cdemetriadis/Thrustmaster-T300-Steering-Wheel-Emulator/hardware-list.md

# Hardware Parts & Tool List
Here's a detailed list of everything that went into building the steering wheel. 

## Parts

1. 1x Arduino Nano (or [compatible ATmega328P](https://grobotronics.com/nano-ch340-atmega328p-compatible-for-arduino-nano-v3.0.html))
0. 1x [16x2 Backlit LCD 3.3V screen](https://grobotronics.com/display-16x2-character-lcd-3.3v-blue.html)
0. 1x [I<sup>2</sup>C LCD Backpack](https://grobotronics.com/lcd-display-i2c-interface-module.html)
0. 3x Rotary Encoders (EC11)
0. 3x [I<sup>2</sup>C Encoder Mini v2.1](http://www.duppa.net/shop/i2c-encoder-mini/) boards
0. 1x [I<sup>2</sup>C Real-time clock](https://grobotronics.com/real-time-clock-module-with-eeprom.html) (DS1307 RTC)
0. 1x [2-5V Buzzer](https://grobotronics.com/buzzer-2-5v-30ma.html)
0. 2x [Mini 8-way Rotary Switches](https://www.hellasdigital.gr/electronics/components/mini-8-way-rotary-selector-switch-sp8t/)
0. 16x Push buttons (6x [NKK Style](https://www.cableworks.gr/ilektronika/arduino-and-microcontrollers/components-and-ic/buttons/ds-612-3-pin-6mm-dpdt-no-nc-red-reset-push-button/), 4x [12mm Momentary](https://grobotronics.com/push-button-momentary-12mm-red.html), 6x [7mm Momentary](https://grobotronics.com/momentary-button-panel-mount-black.html))
0. 2x [(ON)-OFF-(ON) Toggle switches](https://grobotronics.com/toggle-switch-on-off-on-sp3t-3a-250v-el.html)
0. 1x [5x7cm perfboard](https://grobotronics.com/50x70mm.html)
0. 1x [20cm USB-Mini extension](https://www.ebay.co.uk/itm/30cm-Angle-Mini-USB-5Pin-Male-to-Female-Extension-Adapter-Cable-Panel-Mount-Type/232825989994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)
0. 1x [6 Pin Mini-din adapter](https://www.3drap.it/product/mini-din-6-replacement-part-for-thrustmaster-wheels/)
0. 1x Steering Wheel enclosure ([F1 Kit by 3Drap.it](https://www.3drap.it/product/f1-steering-wheel-kit-by-3drap-thrustmaster-logitech-osw/))
0. Lots of 24-30AWG wires
0. Lots of Dupont type connectors
0. Pin Headers (Male/Female)
0. Various heatshrink tubes

## Tools

1. Soldering iron
0. Solder
0. Wire cutters
0. Needle nose pliers
0. Tweezers
0. Small philips screwdriver
0. Allen keys
0. Drill
0. USB to Mini USB (for programming the Arduino Nano)
