cdemetriadis/Thrustmaster-T300-Steering-Wheel-Emulator/button-mapping.md

# Button Mapping

Here are all the control bindings I've set in Assetto Corsa Competizione. These are mapped for the Playstation DualShock 4 controller.

| Wheel | PlayStation | Assetto Corsa Competizione |
| --- | --- | --- |
| Pit (Triangle) | **Triangle** | Pit Limiter |
| MFD (Square) | **Square** | Next Dash Page |
| HUD (Cross) | **Cross** | Cycle HUD MFD Up |
| Flash (Circle) | **Circle** | Flasher |
| L1 | **L1** | Shift Down |
| R1 | **R1** | Shift Up |
| L2 / Wipers | **L2** | Cycle Wiper |
| R2 / Lights | **R2** | Cycle Light Stages |
| L3 | **L3** | Decrease ABS |
| R3 | **R3** | Increase ABS |
| Toggle Up | **D-Pad Up** | Increase Brake Bias |
| Toggle Down | **D-Pad Down**  | Decrease Brake Bias |
| Toggle Right | **D-Pad Right** | Increase Traction Control  |
| Toggle Left | **D-Pad Left**  | Decrease Traction Control  |
