cdemetriadis/Thrustmaster-T300-Steering-Wheel-Emulator/(threads)

Thread 3 (2020-11-23):

CAB / Display Bug

cdemetriadis, 2020-11-23:
When the display is switched off I noticed that the CAB Mode button does not function properly. It does not properly select the mode.

I've tested the voltage and everything seems to be just fine. I need to further investigate as I currently do not know what is wrong.

Closed 2022-09-30.

Thread 10 (2021-04-06):

Button problem

Shane87F3Ng, 2021-04-06:

Closed 2021-04-06.

Thread 9 (2021-04-06):

Buttons are not constant

Shane87F3Ng, 2021-04-06:
First of all, thanks for the amazing work,

I realized, that Buttons are not constant pressed but flicker a lot. I do not use a rtc nor a display, just 3 encoders as you and some buttons. Therefore I modified the code, but it also happens with the original one. If i keep the button pushed, it is like i would very very very frequently push it. Any chance to look into it or does it happen because i do not use RTC, nor buzzer or reset? I use it on a TS-PC.

Best Regards!

cdemetriadis, 2021-04-07:
Try playing with the DEBOUNCE number. Currently it is on 90, but you could try raising it.

Shane87F3Ng, 2021-04-07:
That did IT! Thank you so much!

A general question, so you work on the advanced mode?

cdemetriadis, 2021-04-08:
> A general question, so you work on the advanced mode?

Not quite sure I understand.

Shane87F3Ng, 2021-04-08:
In the description, you said, that the advanced mode for PC is not yet working. So my question was, If you are still looking into that or if it was just a note :)

cdemetriadis, 2021-04-08:
Oh, that's just a note. I do not use a PC for gaming, so cannot test it.

I'm assuming the transition wouldn't be too hard though.

cdemetriadis, 2021-04-20:
Hey @Shane87F3Ng, I've added a new branch that works with the PC Advanced mode. Check it out here https://github.com/cdemetriadis/Thrustmaster-T300-Steering-Wheel-Emulator/tree/PC-Advanced-Mode

Shane87F3Ng, 2021-04-21:
Thanks for the Info! I will try it and see, if can use more buttons :)

cdemetriadis, 2021-04-22:
@Shane87F3Ng You can find the PC bindings here https://github.com/cdemetriadis/Thrustmaster-T300-Steering-Wheel-Emulator/blob/PC-Advanced-Mode/control-bindings.md

Closed 2021-04-19.

Thread 12 (2022-03-30):

Wire.h

Shane87F3Ng, 2022-03-30:
Hey mate,

Thanks again for your awesome work. I am building my second wheel at this point. I run into a problem. The original code does not include wire.h and wire.begin, but now, without including them, the arduino is stuck at setup while initialising the encoders..

Do you have any hint why this is happening? Which version of i2cminiencoderlib.h do you use?

Greetings

Closed 2022-03-30.

Thread 13 (2022-07-17):

T300 F1 wheel no display

les100, 2022-07-17:
Hi,
Thanks for your generosity in providing full details of your build. I am having a problem with not being able to display anything.
I have loaded the i2c demo from arduino ide and get the hello world. Loading your code i get nothing. I wondered if it had anything to do with the display on/off switch but cant see in your docs where this switch is connected. I even disconnected everything and just had the Display and nano connected and still nothing. Any help would be appreciated. Thanks,  Les

les100, 2022-07-18:
Thanks but i managed to sort it out.

eroyee, 2022-07-19:
@cdemetriadis I believe this issue was due to the OP not initialising the eeprom from t300_functions.ino?

Not sure whether you have any (software) build instructions but maybe it's worth including information around this and/or an if statement in the main code that will inform the operator if the eeprom is empty?

Apologies for not being specifically helpful and offering explicit code/text around this, but I'm not a user of your system (or indeed any such thing) and would hesitate to give further input without experience of what I was talking about... ;-)

les100, 2022-07-19:
@eroyee  Thanks for your suggestion,you were 100% correct,never had to do this before.A note to that effect would have been helpful.

cdemetriadis, 2022-07-19:
@eroyee @les100 Sorry for not being responsive on this issue. I've not touched this code in a while. I'd be more than happy if any of you contributed directly to the projected and made a pull request.

Thread 14 (2022-09-15):

Encoders displaying opposite Polarity

les100, 2022-09-15:
Hi,
When rotating any of the encoders anticlockwise is displaying + and clockwise a -.What have i got wrong.I am a novice with Arduino sorry.

Thanks
Les

cdemetriadis, 2022-09-30:
Hey there Les,

So, as I’ve already mentioned this in a reply somewhere on the internets, you could save this with a software change. I cannot test this change currently as I’ve not a working version of the wheel/arduino. BUT, it should be fairly straight forward.

In the `t300_functions.ino` file, you will find the trigger for each of the Encoders. Line 36 and onward:

```
void encoderBB_decrement(i2cEncoderMiniLib* obj) {
 buttonValue = 1100;
}
void encoderBB_increment(i2cEncoderMiniLib* obj) {
 buttonValue = 1000;
}
void encoderABS_decrement(i2cEncoderMiniLib* obj) {
 buttonValue = 3000;
}
void encoderABS_increment(i2cEncoderMiniLib* obj) {
 buttonValue = 3100;
}
void encoderTC_decrement(i2cEncoderMiniLib* obj) {
 buttonValue = 2000;
}
void encoderTC_increment(i2cEncoderMiniLib* obj) {
 buttonValue = 2100;
}
```

To swap the -/+ actions, you’d probably only need to change the buttonValue for each. As an example, in this case, your code should become:

```
void encoderBB_decrement(i2cEncoderMiniLib* obj) {
 buttonValue = 1000;
}
void encoderBB_increment(i2cEncoderMiniLib* obj) {
 buttonValue = 1100;
}
void encoderABS_decrement(i2cEncoderMiniLib* obj) {
 buttonValue = 3100;
}
void encoderABS_increment(i2cEncoderMiniLib* obj) {
 buttonValue = 3000;
}
void encoderTC_decrement(i2cEncoderMiniLib* obj) {
 buttonValue = 2100;
}
void encoderTC_increment(i2cEncoderMiniLib* obj) {
 buttonValue = 2000;
}
```

But again, please forgive me as I cannot double check and test the above.

Trust me when I say that all of the code you see was initially trial and error for me as well ;)

Best of luck buddy!

Closed 2022-09-30.

Thread 15 (2023-06-16):

Clean Thrustmaster F1 code

miniraziel, 2023-06-16:
Hi, i've seen you fantastic job about this project a few time ago, i've made myself too a few wheels using T300RS emulation and also a work in progress with T-GT emulation(thanks to Taras for his work), i would like to ask you if it is possible for you to publish the code to emulate the Thrustmaster F1 wheel(the one you used for this project), but in a clean version. I mean without screen controls and in the original buttons form(like the original F1 wheel: 18 buttons and 2 encoders). I've already try to contact Bremme on thingiverse for the original code but i didn't gen answer... and Taras told me that he don't have the time to work anymore on these projects.
I'm not a programmer and except for a few buttons reordering i'm not able to modify your sketch or the bremme's one.
Thank you very much
Best regards
Roberto

miniraziel, 2023-06-16:
Wrong position, not an issue but a request.
sorry

Closed 2023-06-16.

Thread 17 (2024-07-05):

Help

Eplesx, 2024-07-05:
Hello,
I don't know if you still provide support on this issue, but,
I did everything right, the lights of the Arduino work when I plug it in, but none of the buttons work. What could be the reason?

I use 14 butons and 2 rotary switches

Eplesx, 2024-07-05:
Thanks for the answer,
I'm trying to use it on a computer too.
I wanted to insert a button and try it, but the button is constantly flashing. When I remove the button, the left button on the d pad on the screen is constantly flashing.
Do you have an idea?

Eplesx, 2024-07-05:
I only have buttons and rotaries, could it be because of the lcdyou added?
