cdemetriadis/Thrustmaster-T300-Steering-Wheel-Emulator/assets/f1-wheel-labels.pdf

TC1

BB

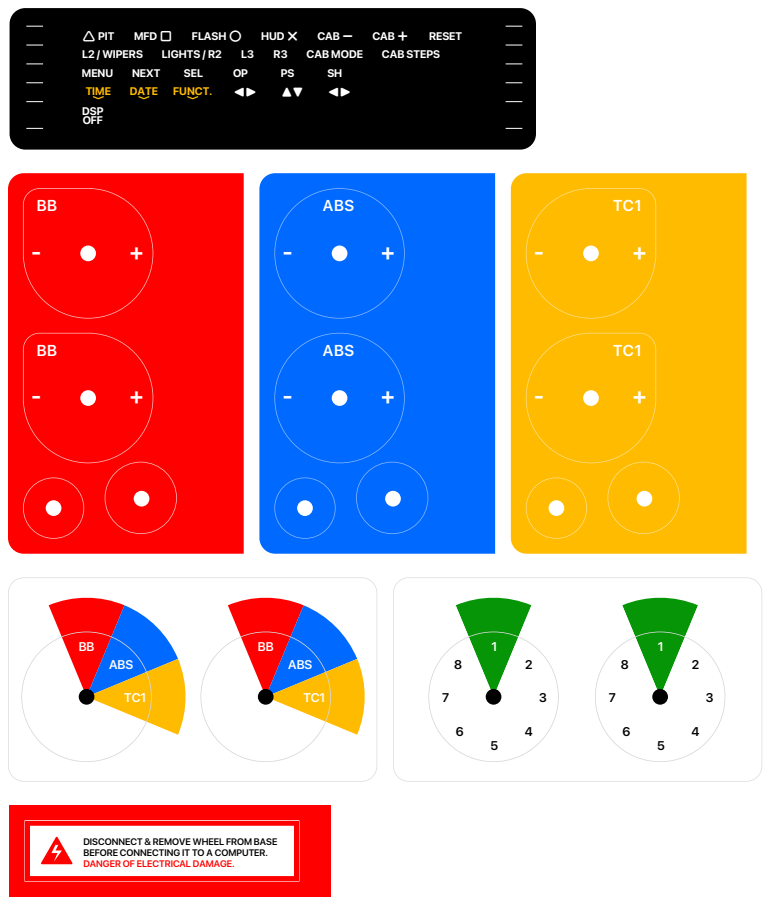
[picture p11: page 1]
ABS; MENU; DSP OFF; TIME; DATE; FUNCT.; NEXT; SEL; L2 / WIPERS; LIGHTS / R2; CAB MODE; CAB STEPS; % PIT; MFD '; FLASH &; HUD (; CAB ); CAB *; RESET; ABS - +

DISCONNECT & REMOVE WHEEL FROM BASE
BEFORE CONNECTING IT TO A COMPUTER.
DANGER OF ELECTRICAL DAMAGE.
