cdemetriadis/Thrustmaster-T300-Steering-Wheel-Emulator/t300_wheel_nano_lcd_switches/t300_wheel_nano_lcd_switches.ino

// Connect to Thrustmaster T300
//
// Arduino GND                        -> T300 Blue wire (2)
// Arduino pin 12                     -> T300 White wire (3) (data from wheel to base)
// Arduino pin 10 + pin 2 (SS)        -> T300 Orange wire pin (4) (yes, on Arduino it's wired to two pins. 10 - SS, 2 - INT0)
// Arduino pin 13 (SCK)               -> T300 Red wire (5)
// Arduino +5V                        -> T300 Black wire (6) (it gives 3.3V, but must be connected into +5V socket on arduino uno side)

#include      <EEPROM.h>                              // Load EEPROM library for storing settings
#include      <LiquidCrystal_I2C.h>                   // Load the Liquid Crystal Display library
#include      <i2cEncoderMiniLib.h>                   // Load I2C encoderBB Library
#include      <TimeLib.h>                             // Load Time Library
#include      <DS1307RTC.h>                           // Load the DS1307 RTC Library
 
#define       DEBUG_SETUP false                       // Debug Setup information
#define       DEBUG_KEYS false                        // Debug the button presses
#define       DEBUG_RESPONSE false                    // Debug the response time
#define       DEBUG_WHEEL false                       // Debug wheel output
#define       Rotary_Switch_T300 true                 // Select the values for the Rotary Switches. 'true:T300', 'false:USB'
#define       MESSAGE_DURATION 750                    // Duration of the messages on the screen
#define       DEBOUNCE 120                            // Set this to the lowest value that gives the best result

#define       MENU "~Ready"
#define       LOADING "Loading..."
#define       SELECT_OPTION " Select Option:"
#define       DISPLAY_MODE_ON "~Display Mode"
#define       DISPLAY_MODE_OFF " Display Mode"
#define       DISPLAY_KEYPRESS_ON "~Disp.Keypress"
#define       DISPLAY_KEYPRESS_OFF " Disp.Keypress"
#define       DISPLAY_STATUS_ON "~Display Off"
#define       DISPLAY_STATUS_OFF " Display Off"
#define       BUZZER_STATUS_ON "~Buzzer"
#define       BUZZER_STATUS_OFF " Buzzer"
#define       HOUR_CHIRP_ON "~Hour Chirp"
#define       HOUR_CHIRP_OFF " Hour Chirp"
#define       DISPLAY_RUNTIME_ON "~Display Runtime"
#define       KEYPRESS_ON "Keypress: On"
#define       KEYPRESS_OFF "Keypress: Off"
#define       MODE_PS "Mode: PS"
#define       MODE_WHEEL "Mode: Wheel"
#define       CHIRP_ON "Hour Chirp: On"
#define       CHIRP_OFF "Hour Chirp: Off"
#define       BUZZER_ON "Buzzer: On"
#define       BUZZER_OFF "Buzzer: Off"

// Setup EEPROM
bool          DISPLAY_MODE = EEPROM.read(0);          // Retrieve the display output mode. 'true:1' for Playstation, 'false:0' for Wheel
bool          DISPLAY_KEYS = EEPROM.read(1);          // Retrieve the display keypress option. 'true:1' on, 'false:0' off
bool          BUZZER_STATUS = EEPROM.read(2);         // Retrieve the buzzer status. 'true:1' on, 'false:0' off
bool          DISPLAY_STATUS = EEPROM.read(3);        // Retrieve the display status. 'true:1' on, 'false:0' off
bool          HOUR_CHIRP = EEPROM.read(4);            // Retrieve the hour chirp status. 'true:1' on, 'false:0' off


// Initialize Encoders
const int     IntPin = 3;
i2cEncoderMiniLib encoderBB(0x20);
i2cEncoderMiniLib encoderABS(0x21);
i2cEncoderMiniLib encoderTC(0x22);
int encoderIncCount = 0;
int encoderDecCount = 0;


// Setup LCD & vars
LiquidCrystal_I2C lcd(0x27, 16, 2);                   // Connects to 3.3V, GND, A4 (SDA), A5 (SCL)
int           curValue = -100;
String        prevLine_1;
String        prevLine_2;
void          printDisplay(String line_1="", int pos_1=0, String line_2="", int pos_2=0);
unsigned long displayTime;                            // Used for delaying the screen message


// Setup Real Time Clock
tmElements_t  tm;
String        getTime;
String        getDate;
bool          chirp_played = true;
String        tm_hour; 
String        tm_minute;
String        tm_month = "--";
String        tm_date = "--";


// Setup Buzzer 
#define       BUZZER_PIN 4
unsigned long buzzerTime;

// Menu Navigation Setup
int           menu = 0;
int           menuPage = 1;
int           maxPages = 1;


// CAB Setup - Combined action buttons
int           triggerCAB;
int           triggerSteps = 0;
int           triggerStepsIncrease = 0;
int           triggerStepsDecrease = 0;
int           CAB_ACTION;
int           CAB_STEPS;
unsigned long cabTrigger = millis();


// Button Matrix
int           foundColumn = 0;
int           buttonValue = 0;
byte          wheelState[8];
volatile      byte pos;


// Setup Button Matrix
int           rowPin[] = {5, 6, 7, 8, 9};           // Set pins for rows > OUTPUT
int           colPin[] = {A0, A1, A2, A3, 11};              // Set pins for columns, could also use Analog pins > INPUT_PULLUP
int           rowSize = sizeof(rowPin)/sizeof(rowPin[0]);
int           colSize = sizeof(colPin)/sizeof(colPin[0]);


// Button Matrix
//      Cols  |  0              1               2               4               5
// Rows Pins  |  14/A0          15/A1           16/A2           17/A3           11
// ---------------------------------------------------------------------------------------------
// 0    5     |  204 Triangle   225 Circle      247 Up          270 L2          147 L1
// 1    6     |  224 Square     246 Cross       269 Down        293 R2          164 R1
// 2    7     |  245 Menu       268 Options     292 left        317 CAB-        182 L3
// 3    8     |  267 Next       291 PS          316 Right       342 CAB+        201 R3
// 4    9     |  290 Select     315 Share       341             368             221


void setup() {
  
  resetVars();

  #if DEBUG_SETUP || DEBUG_KEYS || DEBUG_WHEEL || DEBUG_RESPONSE
     Serial.begin(115200);    // Arduino debug console
  #endif

  pinMode(MISO, OUTPUT); // Arduino is a slave device
  SPCR |= _BV(SPE);      // Enables the SPI when 1
  SPCR |= _BV(SPIE);     // Enables the SPI interrupt when 1

  pinMode(BUZZER_PIN, OUTPUT); // Set buzzer pin as OUTPUT
  
  // Interrupt for SS rising edge
  attachInterrupt (digitalPinToInterrupt(2), ss_rising, RISING); // Interrupt for Button Matrix
  
  // Setup Encoders
  pinMode(IntPin, INPUT);
  encoderBB.begin(i2cEncoderMiniLib::IPUP_ENABLE);
  encoderBB.onIncrement = encoderBB_increment;
  encoderBB.onDecrement = encoderBB_decrement;
  encoderABS.begin(i2cEncoderMiniLib::IPUP_ENABLE);
  encoderABS.onIncrement = encoderABS_increment;
  encoderABS.onDecrement = encoderABS_decrement;
  encoderABS.onButtonLongPush = toggleBacklight;
  encoderABS.writeDoublePushPeriod(50);
  encoderTC.begin(i2cEncoderMiniLib::IPUP_ENABLE);
  encoderTC.onIncrement = encoderTC_increment;
  encoderTC.onDecrement = encoderTC_decrement;

  encoderBB.autoconfigInterrupt();
  encoderABS.autoconfigInterrupt();
  encoderTC.autoconfigInterrupt();

  
  // Setup Display & Init message
  lcd.init();
  
  if (DISPLAY_STATUS) {
    lcd.backlight();
    lcd.clear();
  } else {
    lcd.noDisplay();
    lcd.noBacklight();
    lcd.clear();
  }

  printDisplay(LOADING);

  #if DEBUG_SETUP
    Serial.println("Thrustmaster Wheel Emulator v1.0");
    Serial.println();
    Serial.print("Setup ");
    Serial.print(rowSize);
    Serial.print("x");
    Serial.print(colSize);
    Serial.println(" Button Matrix");
  #endif

  // Row setup
  //
  // Set rows as OUTPUT
  for (int i=0; i<rowSize; i++) {
    pinMode(rowPin[i], OUTPUT);
    #if DEBUG_SETUP
      Serial.print("Pin: ");
      Serial.print(rowPin[i]);
      Serial.print(" is set as OUTPUT on row: ");
      Serial.println(i);
    #endif
  }

  // Column setup
  //
  // Set columns as INPUT_PULLUP
  for (int i=0; i<colSize; i++) {
    pinMode(colPin[i], INPUT_PULLUP);
    #if DEBUG_SETUP
      Serial.print("Pin: ");
      Serial.print(colPin[i]);
      Serial.print(" is set as INPUT_PULLUP on col: ");
      Serial.println(i);
    #endif
  }
  
  if (BUZZER_STATUS) {
    buzzerStartup();
  }

}


// Interrupt0 (external, pin 2) - prepare to start the transfer
void ss_rising () {
  SPDR = wheelState[0]; // load first byte into SPI data register
  pos = 1;
}


// SPI interrupt routine
ISR (SPI_STC_vect) {
  SPDR = wheelState[pos++]; // load the next byte to SPI output register and return.
}


String CABActionMap[] = {
  "BB",
  "ABS",
  "TC"
};

int CABActionGuide[3][2][2] = {
  { // BB
    {2, B10111111},   // D-Pad Down - wheelState[2] = wheelState[2] & B10111111;
    {2, B11110111}    // D-Pad Up - wheelState[2] = wheelState[2] & B11110111;
  },
  { // ABS
    {1, B11111101},  // L3 - wheelState[1] = wheelState[1] & B11111101;
    {1, B11111110}   // R3 - wheelState[1] = wheelState[1] & B11111110;
  },
  { // TC
    {2, B11101111},   // D-Pad Left - wheelState[2] = wheelState[2] & B11101111;
    {2, B11011111}    // D-Pad Right - wheelState[2] = wheelState[2] & B11011111;
  }
};

void loop() {
  
  #if DEBUG_RESPONSE
    unsigned long startLoop = micros();
  #endif
  
  if (digitalRead(IntPin) == LOW) {
    encoderBB.updateStatus();
    encoderABS.updateStatus();
    encoderTC.updateStatus();
  }

  //
  // Initiate Button Matrix
  // This functions returns a buttonValue for each button
  scanButtonMatrix();

  //
  // Set the action based on the buttonValue
  switch (buttonValue) {

    case 204: // Triangle
      wheelState[0] = wheelState[0] & B11111101;
      buzzer();
      if (DISPLAY_KEYS) {
        (DISPLAY_MODE) ? printDisplay("Triangle", 4) : printDisplay("Pit Limiter", 2);
        menu = 0;
      }
      #if DEBUG_KEYS
        Serial.print("Triangle ("); Serial.print(buttonValue); Serial.println(") ");
      #endif
      break;

    case 224: // Square
      wheelState[0] = wheelState[0] & B11111110;
      buzzer();
      if (DISPLAY_KEYS) {
        (DISPLAY_MODE) ? printDisplay("Square", 5) : printDisplay("MFD", 6);
        menu = 0;
      }
      #if DEBUG_KEYS
        Serial.print("Square ("); Serial.print(buttonValue); Serial.println(") ");
      #endif
      break;

    case 245: // Menu (Display)
      buzzer();
      if (DISPLAY_STATUS) {
        if (menu == 1) {
          resetMenu();
        } else if (menu == 2) {
          menu = 1;
          menuPage = 1;
        } else if (menu == 3) {
          menu = 1;
          menuPage = 2;
        } else {
          menuPage = 1;
          menu = 1;
        }
        showMenu();
      } else {
        lcd.display();
        lcd.backlight();
        DISPLAY_STATUS = 1;
        EEPROM.write(3, DISPLAY_STATUS);
      }
      
      #if DEBUG_KEYS
        Serial.print("Done ("); Serial.print(buttonValue); Serial.println(") ");
      #endif
      break;

    case 267: // Next (Display)
      buzzer();
      lcd.display();
      lcd.backlight();
      DISPLAY_STATUS = 1;
      EEPROM.write(3, DISPLAY_STATUS);
      displayNext();
      #if DEBUG_KEYS
        Serial.print("Next ("); Serial.print(buttonValue); Serial.println(") ");
      #endif
      break;

    case 290: // Select (Display)
      buzzer();
      lcd.display();
      lcd.backlight();
      DISPLAY_STATUS = 1;
      EEPROM.write(3, DISPLAY_STATUS);
      displaySelect();
      #if DEBUG_KEYS
        Serial.print("Select("); Serial.print(buttonValue); Serial.println(") ");
      #endif
      break;




    case 225: // Circle
      wheelState[0] = wheelState[0] & B01111111;
      buzzer();
      if (DISPLAY_KEYS) {
        (DISPLAY_MODE) ? printDisplay("Circle", 5) : printDisplay("Flash", 5);
        menu = 0;
      }
      #if DEBUG_KEYS
        Serial.print("Circle ("); Serial.print(buttonValue); Serial.println(") ");
      #endif
      break;

    case 246: // Cross
      wheelState[1] = wheelState[1] & B10111111;
      buzzer();
      if (DISPLAY_KEYS) {
        (DISPLAY_MODE) ? printDisplay("Cross", 5) : printDisplay("HUD", 6);
        menu = 0;
      }
      #if DEBUG_KEYS
        Serial.print("Cross ("); Serial.print(buttonValue); Serial.println(") ");
      #endif
      break;

    case 268: // Options
      wheelState[1] = wheelState[1] & B11101111;
      buzzer();
      if (DISPLAY_KEYS) {
        printDisplay("Options", 4);
        menu = 0;
      }
      #if DEBUG_KEYS
        Serial.print("Options ("); Serial.print(buttonValue); Serial.println(") ");
      #endif
      break;

    case 291: // Playstation
      wheelState[1] = wheelState[1] & B01111111;
      buzzer();
      if (DISPLAY_KEYS) {
        printDisplay("Playstation", 2);
        menu = 0;
      }
      #if DEBUG_KEYS
        Serial.print("Playstation ("); Serial.print(buttonValue); Serial.println(") ");
      #endif
      break;

    case 315: // Share
      wheelState[1] = wheelState[1] & B11011111;
      buzzer();
      if (DISPLAY_KEYS) {
        printDisplay("Share", 5);
        menu = 0;
      }
      #if DEBUG_KEYS
        Serial.print("Share ("); Serial.print(buttonValue); Serial.println(") ");
      #endif
      break;




    case 247: // D-Pad Up
      wheelState[2] = wheelState[2] & B11110111; // DP-Up
      buzzer();
      if (DISPLAY_KEYS) {
        printDisplay("Up", 7);
        menu = 0;
      }
      #if DEBUG_KEYS
        Serial.print("Up ("); Serial.print(buttonValue); Serial.println(") ");
      #endif
      break;

    case 269: // D-Pad Down
      wheelState[2] = wheelState[2] & B10111111; // DP-Down
      buzzer();
      if (DISPLAY_KEYS) {
        printDisplay("Down", 6);
        menu = 0;
      }
      #if DEBUG_KEYS
        Serial.print("Down ("); Serial.print(buttonValue); Serial.println(") ");
      #endif
      break;

    case 292: // D-Pad Left
      wheelState[2] = wheelState[2] & B11101111; // DP-Left
      buzzer();
      if (DISPLAY_KEYS) {
        printDisplay("Left", 5);
        menu = 0;
      }
      #if DEBUG_KEYS
        Serial.print("Left ("); Serial.print(buttonValue); Serial.println(") ");
      #endif
      break;

    case 316: // D-Pad Right
      wheelState[2] = wheelState[2] & B11011111; // DP-Right
      buzzer();
      if (DISPLAY_KEYS) {
        printDisplay("Right", 5);
        menu = 0;
      }
      #if DEBUG_KEYS
        Serial.print("Right ("); Serial.print(buttonValue); Serial.println(") ");
      #endif
      break;

    case 341: // D-Pad Confirm
      wheelState[1] = wheelState[1] & B10111111;
      buzzer();
      if (DISPLAY_KEYS) {
        (DISPLAY_MODE) ? printDisplay("Cross", 5) : printDisplay("Confirm", 4);
        menu = 0;
      }
      #if DEBUG_KEYS
        Serial.print("Cross ("); Serial.print(buttonValue); Serial.println(") ");
      #endif
      break;



    case 270: // L2
      wheelState[1] = wheelState[1] & B11111011;
      buzzer();
      if (DISPLAY_KEYS) {
        (DISPLAY_MODE) ? printDisplay("L2", 7) : printDisplay("Wipers", 5);
        menu = 0;
      }
      #if DEBUG_KEYS
        Serial.print("L2 ("); Serial.print(buttonValue); Serial.println(") ");
      #endif
      break;

    case 293: // R2
      wheelState[1] = wheelState[1] & B11110111;
      buzzer();
      if (DISPLAY_KEYS) {
        (DISPLAY_MODE) ? printDisplay("R2", 7) : printDisplay("Lights", 5);
        menu = 0;
      }
      #if DEBUG_KEYS
        Serial.print("R2 ("); Serial.print(buttonValue); Serial.println(") ");
      #endif
      break;

    case 317: // 290 CAB-L Combined Action Button Left
      buzzer();

      triggerCAB = getCABAction();
      triggerStepsDecrease = getCABSteps(); // triggerStepsDecrease + getCABSteps();

      if (DISPLAY_KEYS) {
        printDisplay(CABActionMap[triggerCAB]+" -"+triggerStepsDecrease, 5);
        menu = 0;
      }
      #if DEBUG_KEYS
        Serial.print("CAB- ("); Serial.print(buttonValue); Serial.println(") ");
      #endif
      break;

    case 342: // 315 CAB-R + Combined Action Button Right
      buzzer();
      
      triggerCAB = getCABAction();
      triggerStepsIncrease = getCABSteps(); // triggerStepsIncrease + getCABSteps();

      if (DISPLAY_KEYS) {
        printDisplay(CABActionMap[triggerCAB]+" +"+triggerStepsIncrease, 5);
        menu = 0;
      }
      #if DEBUG_KEYS
        Serial.print("CAB+ ("); Serial.print(buttonValue); Serial.println(") ");
      #endif
      break;



      
    case 147: // L1
      wheelState[0] = wheelState[0] & B11110111;
      buzzer();
      if (DISPLAY_KEYS) {
        (DISPLAY_MODE) ? printDisplay("L1", 7) : printDisplay("Shift Down", 3);
        menu = 0;
      }
      #if DEBUG_KEYS
        Serial.print("L1 ("); Serial.print(buttonValue); Serial.println(") ");
      #endif
      break;

    case 164: // R1
      wheelState[0] = wheelState[0] & B11111011;
      buzzer();
      if (DISPLAY_KEYS) {
        (DISPLAY_MODE) ? printDisplay("R1", 7) : printDisplay("Shift Up", 4);
        menu = 0;
      }
      #if DEBUG_KEYS
        Serial.print("R1 ("); Serial.print(buttonValue); Serial.println(") ");
      #endif
      break;
      
    case 182: // L3
      wheelState[1] = wheelState[1] & B11111101;
      buzzer();
      if (DISPLAY_KEYS) {
        (DISPLAY_MODE) ? printDisplay("L3", 7) : printDisplay("ABS-", 6);
        menu = 0;
      }
      #if DEBUG_KEYS
        Serial.print("L3 ("); Serial.print(buttonValue); Serial.println(") ");
      #endif
      break;

    case 201: // R3
      wheelState[1] = wheelState[1] & B11111110;
      buzzer();
      if (DISPLAY_KEYS) {
        (DISPLAY_MODE) ? printDisplay("R3", 7) : printDisplay("ABS+", 6);
        menu = 0;
      }
      #if DEBUG_KEYS
        Serial.print("R3 ("); Serial.print(buttonValue); Serial.println(") ");
      #endif
      break;



    //
    // Encoder Functions
    case 1000: // D-Pad Up
//      wheelState[3] = wheelState[3] & B11110111; // CHRG+
      wheelState[2] = wheelState[2] & B11110111; // DP-Up
      encoderIncCount++;
      buzzer();
      if (DISPLAY_KEYS) {
        (DISPLAY_MODE) ? printDisplay("Up x"+String(encoderIncCount), 5) : printDisplay("BB +"+String(encoderIncCount), 5); 
        menu = 0;
      }
      #if DEBUG_KEYS
        Serial.print("D-Pad Up ("); Serial.print(buttonValue); Serial.println(") ");
      #endif
      break;

    case 1100: // D-Pad Down
//      wheelState[3] = wheelState[3] & B10111111; // CHRG-
      wheelState[2] = wheelState[2] & B10111111; // DP-Down
      encoderDecCount++;
      buzzer();
      if (DISPLAY_KEYS) {
        (DISPLAY_MODE) ? printDisplay("Down x"+String(encoderDecCount), 4) : printDisplay("BB -"+String(encoderDecCount), 5);
        menu = 0;
      }
      #if DEBUG_KEYS
        Serial.print("D-Pad Down ("); Serial.print(buttonValue); Serial.println(") ");
      #endif
      break;

    case 2000: // D-Pad Left
//      wheelState[3] = wheelState[3] & B11011111; // DIF IN+
      wheelState[2] = wheelState[2] & B11101111; // DP-Left
      encoderDecCount++;
      buzzer();
      if (DISPLAY_KEYS) {
        (DISPLAY_MODE) ? printDisplay("Left x"+String(encoderDecCount), 4) : printDisplay("TC -"+String(encoderDecCount), 5);
        menu = 0;
      }
      #if DEBUG_KEYS
        Serial.print("D-Pad Left ("); Serial.print(buttonValue); Serial.println(") ");
      #endif
      break;

    case 2100: // D-Pad Right
//      wheelState[3] = wheelState[3] & B11101111; // DIF IN-
      wheelState[2] = wheelState[2] & B11011111; // DP-Right
      encoderIncCount++;
      buzzer();
      if (DISPLAY_KEYS) {
        (DISPLAY_MODE) ? printDisplay("Right x"+String(encoderIncCount), 4) : printDisplay("TC +"+String(encoderIncCount), 5);
        menu = 0;
      }
      #if DEBUG_KEYS
        Serial.print("D-Pad Right ("); Serial.print(buttonValue); Serial.println(") ");
      #endif
      break;

    case 3000: // L3
      wheelState[1] = wheelState[1] & B11111101; // Pump
      encoderDecCount++;
      buzzer();
      if (DISPLAY_KEYS) {
        (DISPLAY_MODE) ? printDisplay("L3 x"+String(encoderDecCount), 5) : printDisplay("ABS -"+String(encoderDecCount), 5);
        menu = 0;
      }
      #if DEBUG_KEYS
        Serial.print("L3 ("); Serial.print(buttonValue); Serial.println(") ");
      #endif
      break;

    case 3100: // R3
      wheelState[1] = wheelState[1] & B11111110; // 1-
      encoderIncCount++;
      buzzer();
      if (DISPLAY_KEYS) {
        (DISPLAY_MODE) ? printDisplay("R3 x"+String(encoderIncCount), 5) : printDisplay("ABS +"+String(encoderIncCount), 5);
        menu = 0;
      }
      #if DEBUG_KEYS
        Serial.print("R3 ("); Serial.print(buttonValue); Serial.println(") ");
      #endif
      break;

    default: // Reset if nothing is pressed
      break;
  }

  // CAB Trigger 
  if (triggerStepsIncrease > 0 && ((millis()-cabTrigger) > (DEBOUNCE*2))) {
    wheelState[CABActionGuide[triggerCAB][1][0]] = wheelState[CABActionGuide[triggerCAB][1][0]] & CABActionGuide[triggerCAB][1][1];
    triggerStepsIncrease--;
    cabTrigger = millis();
  }
  if (triggerStepsDecrease > 0 && ((millis()-cabTrigger) > (DEBOUNCE*2))) {
    wheelState[CABActionGuide[triggerCAB][0][0]] = wheelState[CABActionGuide[triggerCAB][0][0]] & CABActionGuide[triggerCAB][0][1];
    triggerStepsDecrease--;
    cabTrigger = millis();
  }

  #if DEBUG_WHEEL
    for (int i = 0; i < 8; i++) {
      Serial.print(wheelState[i], BIN);
      Serial.print(" ");
    }
    Serial.println();
  #endif
  
  // Reset Display if nothing is pressed for the MESSAGE_DURATION
  if (menu == 0) {
    if ((millis()-displayTime) > MESSAGE_DURATION) { // Change only if there's a change
      showMenu(); // Too much delay
      curValue = buttonValue;
      encoderIncCount = 0;
      encoderDecCount = 0;
    }
  }

  if (HOUR_CHIRP) {
    if (tm.Minute == 0 && chirp_played == false) {
      buzzerHour();
      chirp_played = true;
    } else if (tm.Minute != 0 && chirp_played == true) {
      chirp_played = false;
    }
  }


  #if DEBUG_RESPONSE
    Serial.println(micros() - startLoop);
  #endif
  
  // Set a delay and reset the keyValue to something that will never match an exisitng keyValue
  delay(DEBOUNCE);
  resetVars();

}

void resetVars() {
  wheelState[0] = B11001111;
  wheelState[1] = B11111111;
  wheelState[2] = B11111111;
  wheelState[3] = B11111111;
  wheelState[4] = B00000000;
  wheelState[5] = B00000000;
  wheelState[6] = B01100000;
  wheelState[7] = B01000000;
  buttonValue = 0;
}

void scanButtonMatrix() {
  for (int rowCounter=0; rowCounter<rowSize; rowCounter++) {
    // Set all rowPins to HIGH
    for(int i=0; i<rowSize; i++) {
      digitalWrite(rowPin[i], HIGH);
    }
    // Set the active rowPin to LOW
    digitalWrite(rowPin[rowCounter], LOW);
    // Then we scan all cols in the col[] array
    for (int colCounter=0; colCounter<colSize; colCounter++) {
      // Scan each pin in column
      foundColumn = digitalRead(colPin[colCounter]);
      // If we find a column
      if(foundColumn==0){
        // Using a Cantor Pairing function we create unique number
        buttonValue = (((rowPin[rowCounter]+colPin[colCounter]) * (rowPin[rowCounter]+colPin[colCounter]+1)) / 2 + colPin[colCounter]);
      }
    }
  }
}

void printDisplay(String line_1="", int pos_1=0, String line_2="", int pos_2=0) {
  if (prevLine_1 != line_1 || prevLine_2 != line_2) {
    lcd.clear();
  }
  lcd.setCursor(pos_1, 0);
  lcd.print(line_1);
  lcd.setCursor(pos_2, 1);
  lcd.print(line_2);
  prevLine_1 = line_1;
  prevLine_2 = line_2;
  displayTime = millis();
}

void encoderBB_decrement(i2cEncoderMiniLib* obj) {
  buttonValue = 1100;
}
void encoderBB_increment(i2cEncoderMiniLib* obj) {
  buttonValue = 1000;
}
void encoderABS_decrement(i2cEncoderMiniLib* obj) {
  buttonValue = 3000;
}
void encoderABS_increment(i2cEncoderMiniLib* obj) {
  buttonValue = 3100;
}
void encoderTC_decrement(i2cEncoderMiniLib* obj) {
  buttonValue = 2000;
}
void encoderTC_increment(i2cEncoderMiniLib* obj) {
  buttonValue = 2100;
}


void showMenu() {
  if (menu == 1) { // Main Menu
    maxPages = 6;
    switch (menuPage) {
      case 1:
        printDisplay(SELECT_OPTION, 0, DISPLAY_MODE_ON, 0);
        break;
      case 2:
        printDisplay(DISPLAY_MODE_OFF, 0, DISPLAY_KEYPRESS_ON, 0);
        break;
      case 3:
        printDisplay(DISPLAY_KEYPRESS_OFF, 0, DISPLAY_STATUS_ON, 0);
        break;
      case 4:
        printDisplay(DISPLAY_STATUS_OFF, 0, BUZZER_STATUS_ON, 0);
        break;
      case 5:
        printDisplay(BUZZER_STATUS_OFF, 0, HOUR_CHIRP_ON, 0);
        break;
      case 6:
        printDisplay(HOUR_CHIRP_OFF, 0, DISPLAY_RUNTIME_ON, 0);
        break;
    }
    delay(DEBOUNCE);
  } else {
    if (DISPLAY_STATUS) {
      getDateTime();
      String message_line1 = getDate + "      " + getTime;
      String message_line2 = MENU;
      printDisplay(message_line1, 0, message_line2, 0);
    }
  }
};

void displayNext() {
  (menuPage >= maxPages) ? menuPage = 1 : menuPage++;
  delay(DEBOUNCE);
  showMenu();
}

void displaySelect() {

  if (menu == 1 && menuPage == 1) { // Display Mode
    toggleDisplayMode();
  }

  if (menu == 1 && menuPage == 2) { // Display Keypress
    toggleDisplayKeypress();
  }

  if (menu == 1 && menuPage == 3) { // Display Off
    toggleBacklight();
  }

  if (menu == 1 && menuPage == 4) { // Buzzer Status
    toggleBuzzerStatus();
  }

  if (menu == 1 && menuPage == 5) { // Hour Chirp
    toggleHourChirp();
  }

  if (menu == 1 && menuPage == 6) { // Display Runtime
    displayRuntime();
  }

}

void toggleDisplayMode() {
  if (DISPLAY_MODE == 1) {
    DISPLAY_MODE = 0;
    printDisplay(MODE_WHEEL, 2);
  } else {
    DISPLAY_MODE = 1;
    printDisplay(MODE_PS, 4);
  }
  EEPROM.write(0, DISPLAY_MODE);
  delay(MESSAGE_DURATION);
  showMenu();
}

void toggleDisplayKeypress() {
  if (DISPLAY_KEYS == 1) {
    DISPLAY_KEYS = 0;
    printDisplay(KEYPRESS_OFF, 1);
  } else {
    DISPLAY_KEYS = 1;
    printDisplay(KEYPRESS_ON, 2);
  }
  EEPROM.write(1, DISPLAY_KEYS);
  delay(MESSAGE_DURATION);
  showMenu();
}

void toggleBacklight() {
  printDisplay(DISPLAY_STATUS_OFF, 2);
  delay(MESSAGE_DURATION);
  lcd.noDisplay();
  lcd.noBacklight();
  DISPLAY_STATUS = 0;
  EEPROM.write(3, DISPLAY_STATUS);
  resetMenu();
}

void toggleBuzzerStatus() {
  if (BUZZER_STATUS == 1) {
    BUZZER_STATUS = 0;
    printDisplay(BUZZER_OFF, 2);
  } else {
    BUZZER_STATUS = 1;
    printDisplay(BUZZER_ON, 3);
    buzzer();
  }
  EEPROM.write(2, BUZZER_STATUS);
  delay(MESSAGE_DURATION);
  showMenu();
}

void toggleHourChirp() {
  if (HOUR_CHIRP == 1) {
    HOUR_CHIRP = 0;
    printDisplay(CHIRP_OFF);
  } else {
    HOUR_CHIRP = 1;
    printDisplay(CHIRP_ON);
  }
  EEPROM.write(4, HOUR_CHIRP);
  delay(MESSAGE_DURATION);
  showMenu();
}

void displayRuntime() {
  
  lcd.clear();
  int runtimeColumn = 4;
  int runtimeRow = 0;
  
  prevLine_1 = " ";
  prevLine_2 = " ";
  displayTime = millis();

  unsigned long allSeconds=millis()/1000;
  int runHours= allSeconds/3600;
  int secsRemaining=allSeconds%3600;
  int runMinutes=secsRemaining/60;
  int runSeconds=secsRemaining%60;

  if (runHours<10) {
    lcd.setCursor(runtimeColumn, runtimeRow);
    lcd.print(0);
    lcd.setCursor(runtimeColumn+1, runtimeRow);
    lcd.print(runHours);
  } else {
    lcd.setCursor(runtimeColumn, runtimeRow);
    lcd.print(runHours);
  }

  lcd.setCursor(runtimeColumn+2, runtimeRow);
  lcd.print(":");

  if (runMinutes<10) {
    lcd.setCursor(runtimeColumn+3, runtimeRow);
    lcd.print(0);
    lcd.setCursor(runtimeColumn+4, runtimeRow);
    lcd.print(runMinutes);
  } else {
    lcd.setCursor(runtimeColumn+3, runtimeRow);
    lcd.print(runMinutes);
  }

  lcd.setCursor(runtimeColumn+5, runtimeRow);
  lcd.print(":");

  if (runSeconds<10) {
    lcd.setCursor(runtimeColumn+6, runtimeRow);
    lcd.print(0);
    lcd.setCursor(runtimeColumn+7, runtimeRow);
    lcd.print(runSeconds);
  } else {
    lcd.setCursor(runtimeColumn+6, runtimeRow);
    lcd.print(runSeconds);
  }
  
  delay(MESSAGE_DURATION);
  showMenu();
}

void resetMenu() {
  menuPage = 1;
  menu = 0;
}

#if Rotary_Switch_T300
  // T300 Values (~3.5V)
  int getCABAction() {
    CAB_ACTION = analogRead(6);
    if (CAB_ACTION >= 770 && CAB_ACTION <= 820) {
      triggerCAB = 0;
    } else if (CAB_ACTION >= 640 && CAB_ACTION <= 690) {
      triggerCAB = 1;
    } else if (CAB_ACTION >= 510 && CAB_ACTION <= 550) {
      triggerCAB = 2;
    }
    return triggerCAB;
  }
  
  int getCABSteps() {
    CAB_STEPS = analogRead(7);
    if (CAB_STEPS >= 510 && CAB_STEPS <= 550) {
      triggerSteps = 1;
    } else if (CAB_STEPS >= 390 && CAB_STEPS <= 420) {
      triggerSteps = 2;
    } else if (CAB_STEPS >= 240 && CAB_STEPS <= 280) {
      triggerSteps = 3;
    } else if (CAB_STEPS >= 110 && CAB_STEPS <= 150) {
      triggerSteps = 4;
    } else if (CAB_STEPS >= 0 && CAB_STEPS <= 60) {
      triggerSteps = 5;
    } else if (CAB_STEPS >= 910 && CAB_STEPS <= 950) {
      triggerSteps = 6;
    } else if (CAB_STEPS >= 770 && CAB_STEPS <= 820) {
      triggerSteps = 7;
    } else if (CAB_STEPS >= 640 && CAB_STEPS <= 690) {
      triggerSteps = 8;
    }
    return triggerSteps;
  }
#else
  // USB Values (~5V)
  int getCABAction() {
    CAB_ACTION = analogRead(6);
    if (CAB_ACTION >= 580 && CAB_ACTION <= 620) {
      triggerCAB = 0;
    } else if (CAB_ACTION >= 480 && CAB_ACTION <= 520) {
      triggerCAB = 1;
    } else if (CAB_ACTION >= 380 && CAB_ACTION <= 420) {
      triggerCAB = 2;
    }
    return triggerCAB;
  }
  
  int getCABSteps() {
    CAB_STEPS = analogRead(7);
    if (CAB_STEPS >= 380 && CAB_STEPS <= 420) {
      triggerSteps = 1;
    } else if (CAB_STEPS >= 280 && CAB_STEPS <= 320) {
      triggerSteps = 2;
    } else if (CAB_STEPS >= 180 && CAB_STEPS <= 220) {
      triggerSteps = 3;
    } else if (CAB_STEPS >= 80 && CAB_STEPS <= 120) {
      triggerSteps = 4;
    } else if (CAB_STEPS >= 80 && CAB_STEPS <= 120) {
      triggerSteps = 5;
    } else if (CAB_STEPS >= 680 && CAB_STEPS <= 720) {
      triggerSteps = 6;
    } else if (CAB_STEPS >= 580 && CAB_STEPS <= 620) {
      triggerSteps = 7;
    } else if (CAB_STEPS >= 480 && CAB_STEPS <= 520) {
      triggerSteps = 8;
    }
    return triggerSteps;
  }
#endif

void buzzer() {
  if (BUZZER_STATUS) {
    tone(BUZZER_PIN, 2500, 50);
    buzzerTime = millis();
  }
}

void buzzerStartup() {
  tone(BUZZER_PIN, 1500, 80);
  delay(100);
  tone(BUZZER_PIN, 1800, 80);
  delay(100);
  tone(BUZZER_PIN, 2400, 80);
  delay(100);
  tone(BUZZER_PIN, 3500, 80);
}

void buzzerHour() {
  tone(BUZZER_PIN, 3000, 80);
  delay(200);
  tone(BUZZER_PIN, 3000, 80);
}

void getDateTime() {

  if (tm.Month && tm.Day) {
    tm_month = String(tm.Month+1);
    tm_date = String(tm.Day);
  }

  if (RTC.read(tm)) {
    if (tm.Hour<10) {
      tm_hour = "0" + String(tm.Hour);
    } else {
      tm_hour = String(tm.Hour);
    }
    if (tm.Minute<10) {
      tm_minute = "0" + String(tm.Minute);
    } else {
      tm_minute = String(tm.Minute);
    }

    getDate = tm_date + "/" + tm_month;
    getTime = tm_hour + ":" + tm_minute;
  } else {
    getDate = "Clock error!";
    getTime = "";
  }
 
}
