cdemetriadis/Thrustmaster-T300-Steering-Wheel-Emulator/(commit log)

2020-08-31 Button Matrix
    Set up a 5x4 Button matrix
2020-09-14 Released the secind interrupt
2020-09-16 Show cur button for 750
2020-09-25 Mapped F1 wheels properly
2020-10-01 Updated with support for LCD
    This is a big update. The script has been successfully tested on a T300 and works as described. All buttons are avaialble, includin L3 and R3.
    I've added two versions, one includes an LCD screen and multiple settings for the wheel.
2020-10-09 Upadetd with i2c Encoders & Switches
2020-10-09 Updated with i2c Encoders
2020-10-09 Adjusted Switch Values to 3.3V
2020-10-15 Added a buzzer (for the LOLz)
    [t300_wheel_nano_lcd_switches.ino]
2020-10-15 Updated the button matrix
2020-10-15 new Button Matrix to accomodate the buzzer
    [t300_wheel_nano_lcd_switches.ino]
2020-11-19 Added shortcut to switch off display
    Now, long press on ABS rotary switches the display off.
    [t300_wheel_nano_lcd_switches.ino]
2020-11-24 Further stability and performance tweaks
    [t300_steering_wheel_emulator.ino]
2020-11-24 Rotary Switch Debug on LCD
2020-11-24 Debug Rotary Switches on Serial for now
2021-02-17 Buzzer Resistor
